tonytsangzen/OpenDigitalFilm/document/ICX493/icx493AQA_pinout.jpg

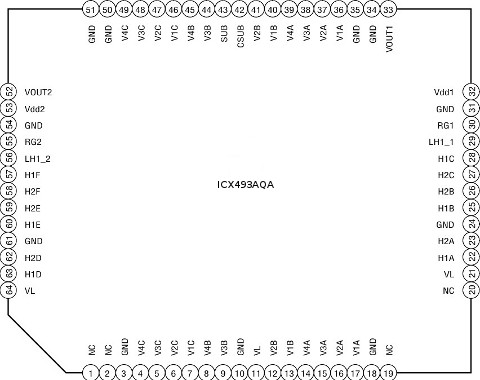
document/ICX493/icx493AQA_pinout.jpg
