tonytsangzen/OpenDigitalFilm/document/Sensor/ICX493_ICX613.jpg

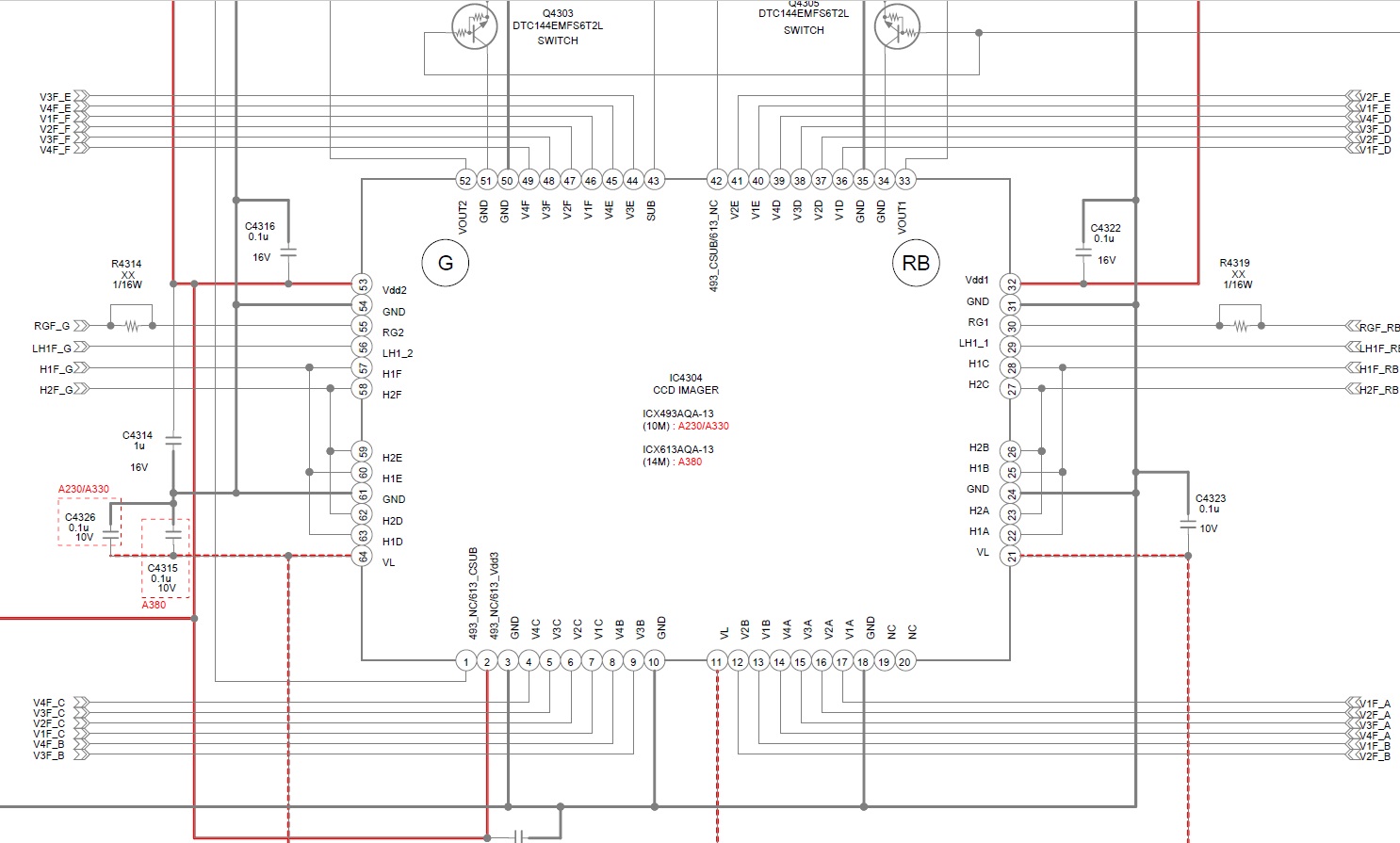
document/Sensor/ICX493_ICX613.jpg
