tonytsangzen/OpenDigitalFilm/document/model-323/10313A.pdf

# TBDXC²S³⁰⁰E⁻xFT256

U4

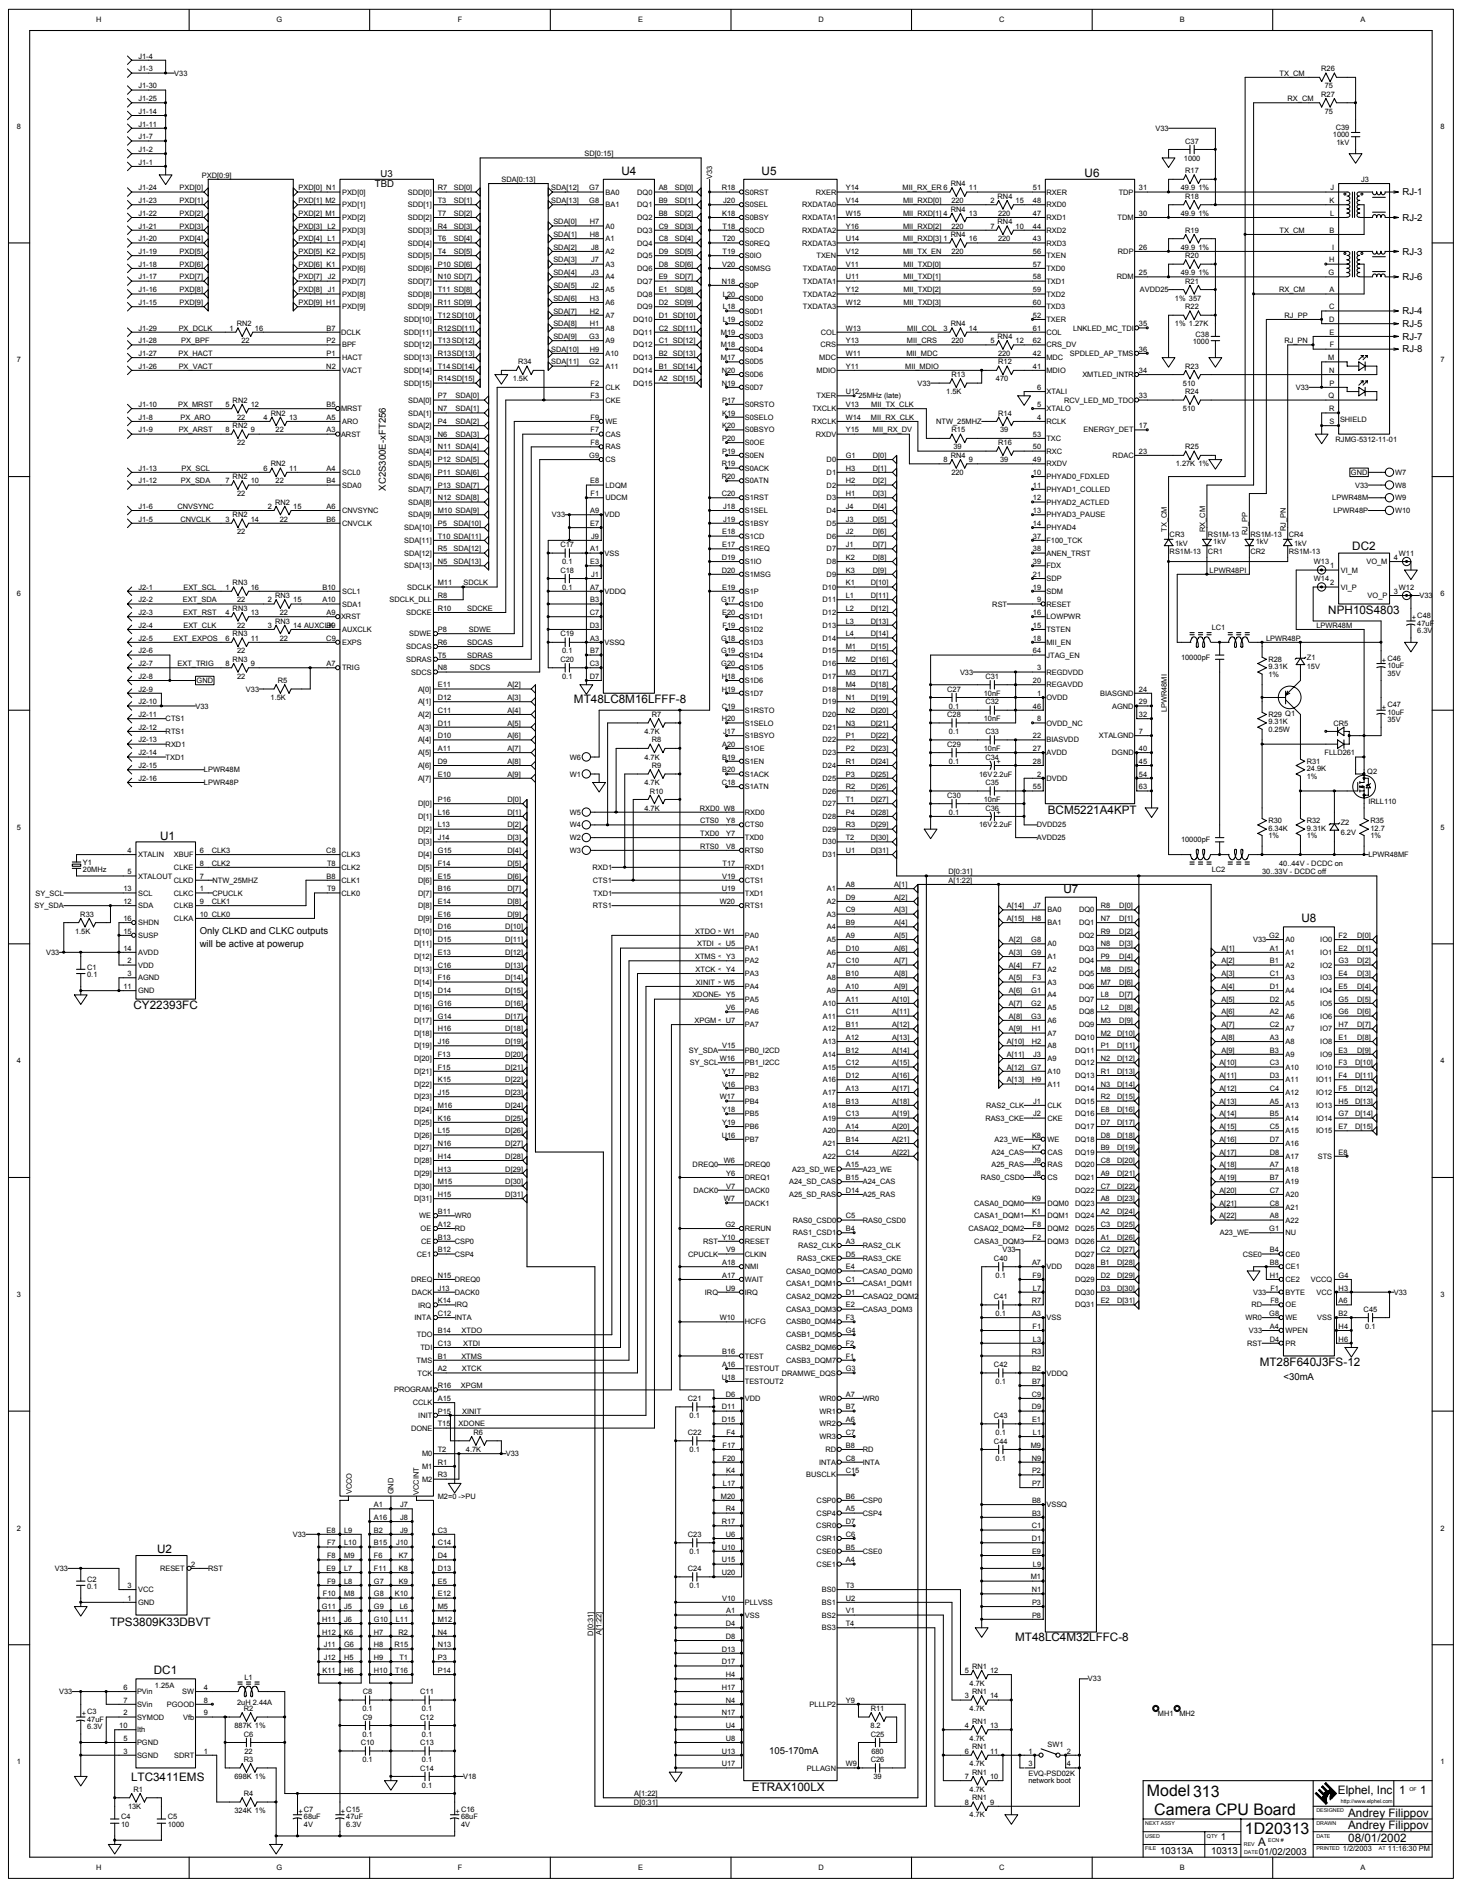
[picture p5: page 1]

6 XBUF
8 CLKE
7 CLKD
1 CLKC
9 CLKB
10 CLKA
Only CLKD and CLKC outputs
will be active at powerup

http://www.elphel.com

NEXT ASSY | 1D20313 A ECN # REV DATE 01/02/2003 | Andrey Filippov DRAWN

USED | QTY 1 | | DATE 08/01/2002

FILE 10313A | 10313 | | PRINTED 1/2/2003 AT 11:16:30 PM
