tonytsangzen/OpenDigitalFilm/(list of files, drawings)

Other design files:
hardware/icx493/icx493.PrjPCB
hardware/icx493/icx493.SchLib
hardware/icx493/port.SchDoc
hardware/ODF1/Driver.SchDoc
hardware/ODF1/new_part.SchLib
hardware/ODF1/ODF1.PrjPCB
hardware/ODF1/ODF1.SchDoc
hardware/ODF1/Power.SchDoc
