tonytsangzen/OpenDigitalFilm/(commit log)

2020-03-08 add some doc
    [icx493.PrjPCB, icx493.SchLib, port.SchDoc]
2020-03-19 add hardware file
    [ODF1.PrjPCB, ODF1.SchDoc, new_part.SchLib]
